aufwaerts/BinSmart-ESS/BinSmart_Termius.jpg

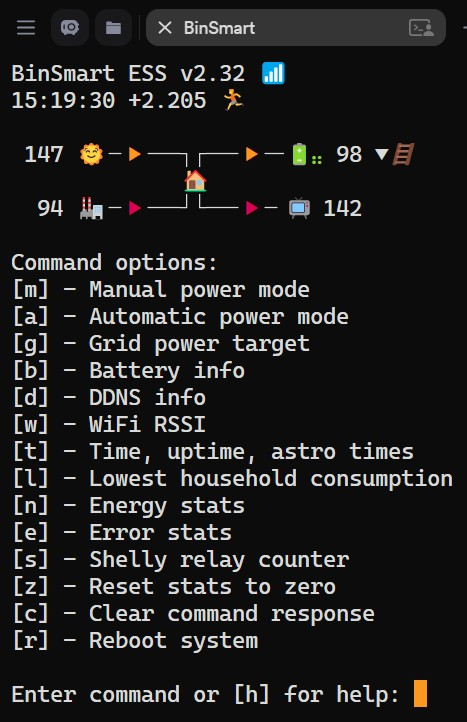
BinSmart_Termius.jpg
