aufwaerts/BinSmart-ESS/BinSmart_Overview.pdf

## Consumers

## Grid

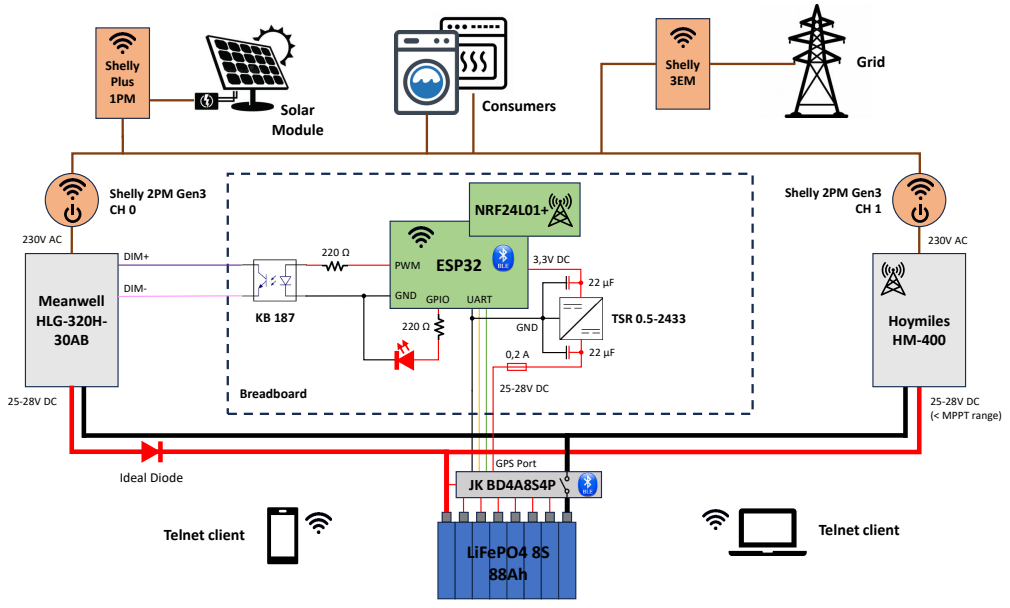
[picture p2: page 1]
LiFePO4 8S 88Ah; Meanwell HLG-320H- 30AB; Shelly 3EM; ESP32; NRF24L01+; Hoymiles HM-400; PWM; DIM+; DIM-; 25-28V DC (< MPPT range); TSR 0.5-2433; UART; Shelly 2PM Gen3 CH 1; Shelly 2PM Gen3 CH 0; Breadboard; Solar Module; GND; Ideal Diode; Shelly Plus 1PM; Telnet client; GPS Port; GPIO
