aufwaerts/BinSmart-ESS/(commit log)

2025-11-29 Update MWPLUG_ON URL to include timer parameter
2025-12-10 Adjust Hoymiles minimum power threshold
2025-12-13 Refine Hoymiles power formula comments and thresholds
2025-12-13 Refactor HoymilesCommand to use constants for power
2025-12-13 Refactor Hoymiles power limit command logic
2025-12-15 Increase POWER_FILTER_CYCLES from 10 to 12
2025-12-28 Update device addresses and error types in config
    [BinSmart_cfg.h]
2025-12-28 Refactor power variables and add energy counters
2025-12-29 Fix formatting and update comments in BinSmart_var.h
    [BinSmart_var.h]
2025-12-30 Update Hoymiles and Meanwell power parameters
2025-12-30 Improve ramp down logic for power limits
    Refactor power limit handling for OVP and UVP modes.
2026-01-01 Enhance power settings and parameters in configuration
    Added power settings and updated existing parameters in BinSmart_cfg.h.
2026-01-01 Add comment in SetNewPower function
    Added comment to clarify the purpose of power limit updates.
2026-01-05 Refactor power limit checks for OVP and UVP modes
2026-01-06 Update time constants from seconds to milliseconds
2026-01-06 Add BMS response buffer and battery state variables
    Added variables for BMS response buffer and battery state of charge.
2026-01-07 Add condition for pm1_eco_mode in power check
2026-01-10 Update flow symbols for ESS, PV, and GRID
2026-01-10 Update battery overflow and under-voltage symbols
2026-01-11 Update flow symbols and replace moon/sun symbols
    [BinSmart_cfg.h]
2026-01-11 Adjust battery protection voltage settings
2026-01-11 Adjust battery full voltage and flow symbols
2026-01-13 Add power limit settings and BMS balancer flag
2026-01-13 Fix condition for calculating PV energy wasted
    [BinSmart.ino]
2026-01-13 Fix return statement in automatic recharge logic
    [BinSmart.ino]
2026-01-14 Remove telnet printing of BMS response
    Removed printing of BMS response to telnet.
2026-01-14 Update BAT_FULL voltage threshold to 27600
2026-01-14 Disconnect BLE client on command failure
    Add disconnect call for BLE client on command failure.
    [BinSmart.ino]
2026-01-14 Refine comments in loop for BMS and power management
    Updated comments for clarity and improved understanding of function calls.
2026-01-15 Fix flow symbols in BinSmart_cfg.h
    [BinSmart_cfg.h]
2026-01-15 Refactor power limit variables in BinSmart_var.h
2026-01-15 Refactor error message variables initialization
    Removed initialization of error_msg and last_error_msg.
    [BinSmart_var.h]
2026-01-15 Update power limit rampdown comments for clarity
2026-01-15 Change OPS_SYMBOL and WIFI_SYMBOL to fixed size arrays
    [BinSmart_cfg.h]
2026-01-15 Refactor BMS/ESS voltage protection settings
2026-01-16 Update voltage protection settings and symbols
2026-01-16 Refactor Shelly device IP addresses and commands
    Updated IP address declarations for Shelly devices and modified the MW_RECHARGE_POWER constant. Adjusted URLs for Shelly commands to use IPAddress types instead of Strings.
2026-01-17 Optimize BMS balancer control
2026-01-17 Remove error reporting for DDNS read IP command
    Removed error message assignment for DDNS read IP command failure.
    [BinSmart.ino]
2026-02-08 Refactor power parameters and add discharge control
    Updated power parameters for Meanwell and Hoymiles, added discharge switch definitions.
2026-02-08 Add hm_awake variable to track Hoymiles power state
2026-02-08 Replace HM_AC_ON and HM_AC_OFF with HM_WAKEUP and HM_SHUTDOWN
    [BinSmart_cfg.h]
2026-02-08 Fix initialization of eco mode variables
    [BinSmart_var.h]
2026-02-12 Remove debug telnet output for RS485 commands
    Removed debug output for RS485 command failures.
    [BinSmart.ino]
2026-02-12 Fix condition for waking up Hoymiles relay
    [BinSmart.ino]
2026-02-13 Adjust delay for BMS response handling
    Increased delay for BMS response based on command type.
2026-02-13 Modify duty cycle minimum and power formulas
    Updated minimum duty cycle and adjusted power formulas for Meanwell.
2026-02-14 Fix condition to check for minimum household consumption
    [BinSmart.ino]
2026-02-14 Add bms_resp_wait_counter to track BMS response delays
2026-02-14 Update timer settings and geographical parameters
2026-02-14 Remove debug print for BMS response completion
    Remove debug message for end of BMS response.
2026-02-15 Adjust PM2 power correction and duty cycle minimum
    [BinSmart_cfg.h]
2026-02-15 Fix type casting in MW_MAX_POWER_FORMULA
    [BinSmart_cfg.h]
2026-02-15 Add battery cell voltage variables to BinSmart_var.h
2026-02-15 Update comments for relay control logic
2026-02-16 Fix RS485 status message formatting
    [BinSmart.ino]
2026-02-16 Fix msecs_cycle comment to reflect milliseconds
    [BinSmart_var.h]
2026-02-17 Change ERROR_TYPE from String to char array
    [BinSmart_cfg.h]
2026-03-02 Fix battery level calculation in BinSmart.ino
    [BinSmart.ino]
2026-03-03 Refactor eco mode and BMS discharge logic
2026-03-05 Update POWER_LIMIT_RAMPDOWN comment for clarity
2026-03-08 Update error handling for PM2_ADDR
    [BinSmart.ino]
2026-03-15 Change balancer switch output to integer format
2026-03-16 Change switch status output to 'on'/'off' format
2026-03-17 Fix WiFi initialization by reordering begin call
    [BinSmart.ino]
2026-03-18 Update VCELL_UVPR voltage setting to 3200 mV
